KoenVdH/Cochlear-Implant-Simulator/templates/drill_template.pdf

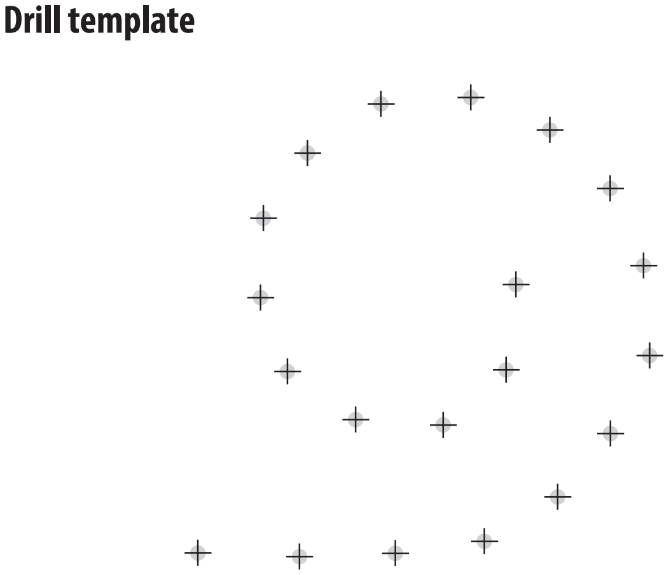
[picture p19: figure]
Cochlear Implant Simulator Drill template
