KoenVdH/Cochlear-Implant-Simulator/templates/front.pdf

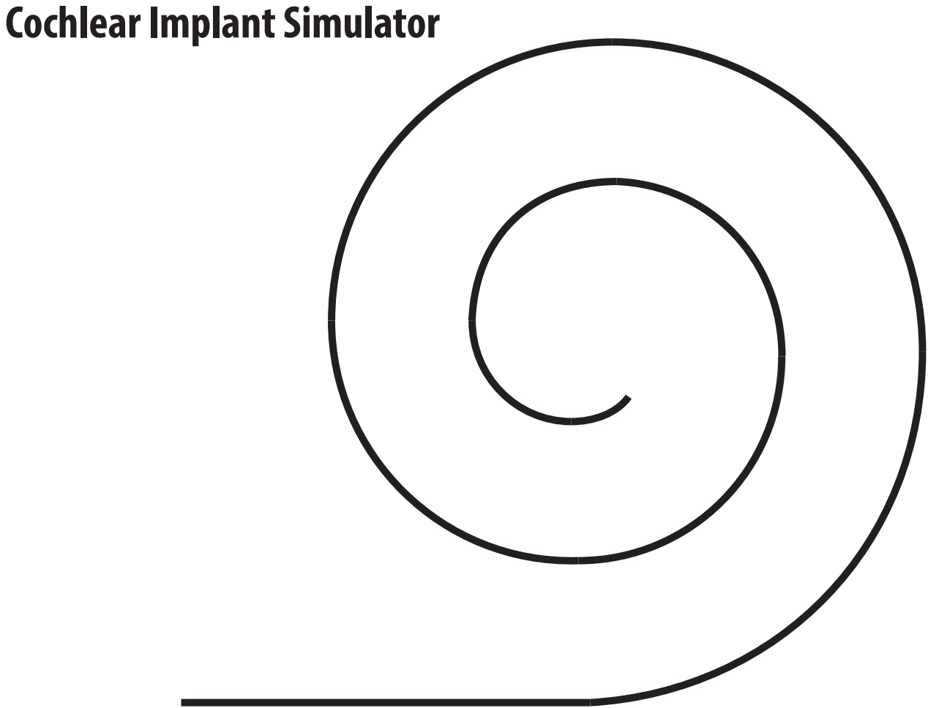
[picture p20: figure]
Cochlear Implant Simulator Drill template
